csosborn/dt-nerdkit/pcb/NerdKit.brd

## EAGLE design pcb/NerdKit.brd (2015-12-04)

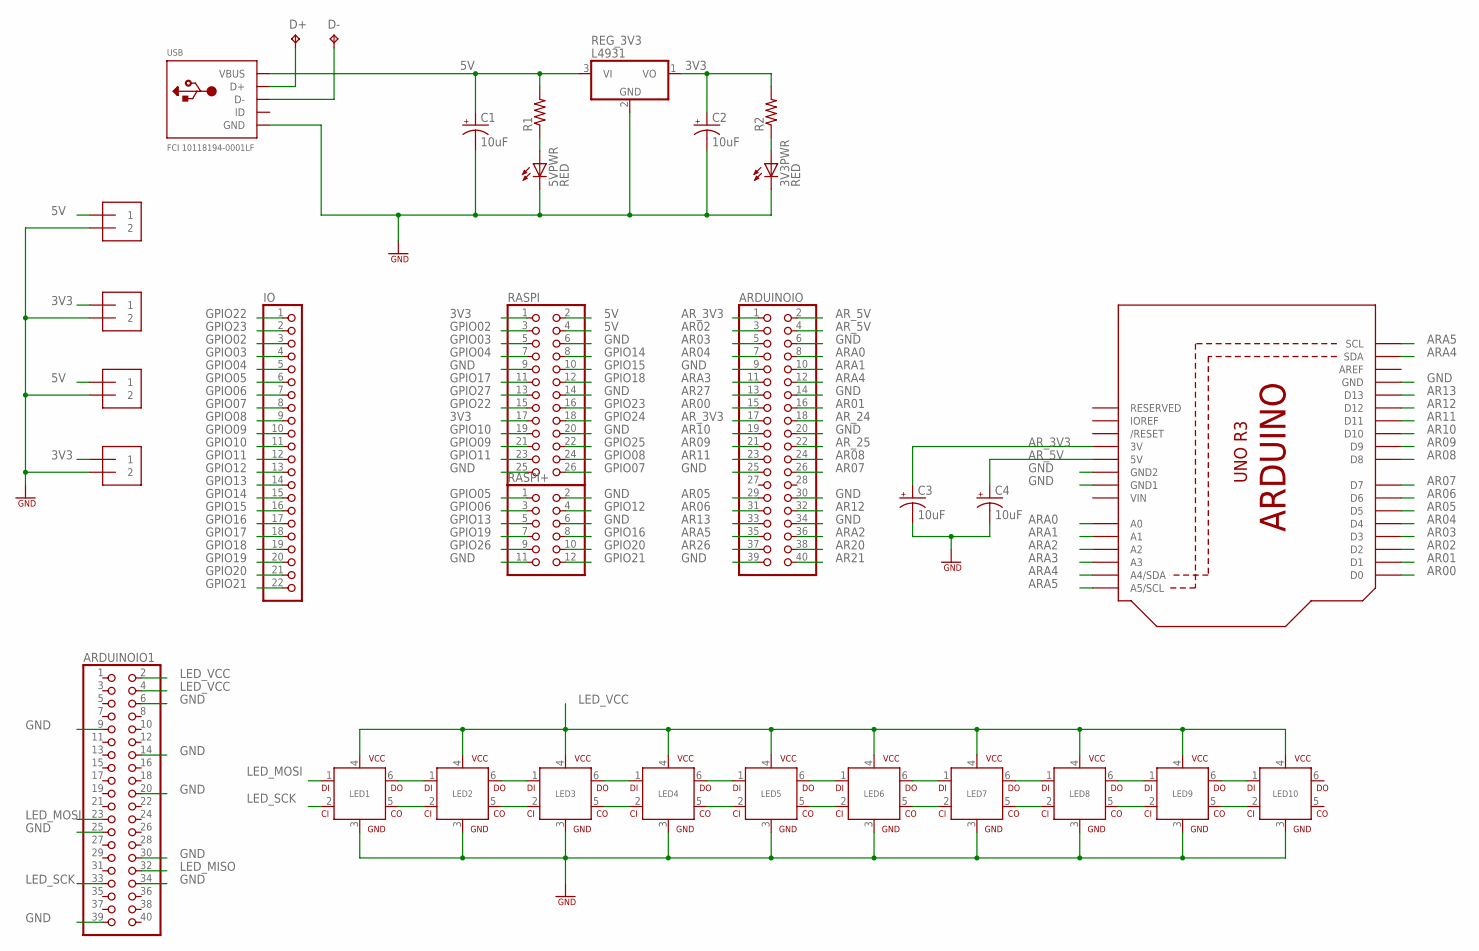
[picture p1: schematic NerdKit.sch]

Parts:
3V3PWR, 5VPWR: RED; LED3MM
ARDUINOIO, ARDUINOIO1: PINHD-2X20; 2X20
C1, C2, C3, C4: 10uF; E1,8-4
D+: TPPAD1-13; P1-13
D-: TPPAD1-13; P1-13
IO: PINHD-1X22; 1X22
LED1, LED2, LED3, LED4, LED5, LED6, LED7, LED8, LED9, LED10: RGBLED5050
PB1_TB_3V3, PB1_TB_5V, PB2_TB_3V3, PB2_TB_5V: 1X2-3.5MM
R1, R2: R-US_0207/7; 0207/7
RASPI: PINHD-2X13; 2X13
RASPI+: PINHD-2X6; 2X06
REG_3V3: L4931; TO92
U2: ARDUINOR3-PINSONLY; ARDUINOR3_PINSONLY
USB: FCI 10118194-0001LF; 4UCONN_20329

Connections:
3V3: C2.+, PB1_TB_3V3.1, PB2_TB_3V3.1, R2.2, RASPI.1, RASPI.17, REG_3V3.1 (VO)
5V: C1.+, PB1_TB_5V.1, PB2_TB_5V.1, R1.2, RASPI.2, RASPI.4, REG_3V3.3 (VI), USB.VBUS
AR00: ARDUINOIO.15, U2.D0
AR01: ARDUINOIO.16, U2.D1
AR02: ARDUINOIO.3, U2.D2
AR03: ARDUINOIO.5, U2.D3
AR04: ARDUINOIO.7, U2.D4
AR05: ARDUINOIO.29, U2.D5
AR06: ARDUINOIO.31, U2.D6
AR07: ARDUINOIO.26, U2.D7
AR08: ARDUINOIO.24, U2.D8
AR09: ARDUINOIO.21, U2.D9
AR10: ARDUINOIO.19, U2.D10
AR11: ARDUINOIO.23, U2.D11
AR12: ARDUINOIO.32, U2.D12
AR13: ARDUINOIO.33, U2.D13
AR20: ARDUINOIO.38
AR21: ARDUINOIO.40
AR26: ARDUINOIO.37
AR27: ARDUINOIO.13
ARA0: ARDUINOIO.8, U2.A0
ARA1: ARDUINOIO.10, U2.A1
ARA2: ARDUINOIO.36, U2.A2
ARA3: ARDUINOIO.11, U2.A3
ARA4: ARDUINOIO.12, U2.A4 (A4/SDA), U2.SDA
ARA5: ARDUINOIO.35, U2.A5 (A5/SCL), U2.SCL
AR_3V3: ARDUINOIO.1, ARDUINOIO.17, C3.+, U2.3V
AR_5V: ARDUINOIO.2, ARDUINOIO.4, C4.+, U2.5V
AR_24: ARDUINOIO.18
AR_25: ARDUINOIO.22
GND: 3V3PWR.K (C), 5VPWR.K (C), ARDUINOIO.6, ARDUINOIO.9, ARDUINOIO.14, ARDUINOIO.20, ARDUINOIO.25, ARDUINOIO.30, ARDUINOIO.34, ARDUINOIO.39, ARDUINOIO1.6, ARDUINOIO1.9, ARDUINOIO1.14, ARDUINOIO1.20, ARDUINOIO1.25, ARDUINOIO1.30, ARDUINOIO1.34, ARDUINOIO1.39, C1.-, C2.-, C3.-, C4.-, LED1.3 (GND), LED2.3 (GND), LED3.3 (GND), LED4.3 (GND), LED5.3 (GND), LED6.3 (GND), LED7.3 (GND), LED8.3 (GND), LED9.3 (GND), LED10.3 (GND), PB1_TB_3V3.2, PB1_TB_5V.2, PB2_TB_3V3.2, PB2_TB_5V.2, RASPI.6, RASPI.9, RASPI.14, RASPI.20, RASPI.25, RASPI+.2, RASPI+.6, RASPI+.11, REG_3V3.2 (GND), U2.GND, U2.GND1, U2.GND2, USB.BASE@1 (GND), USB.BASE@2 (GND), USB.GND, USB.SPRT@1 (GND), USB.SPRT@2 (GND), USB.SPRT@3 (GND), USB.SPRT@4 (GND)
GPIO02: IO.3, RASPI.3
GPIO03: IO.4, RASPI.5
GPIO04: IO.5, RASPI.7
GPIO05: IO.6, RASPI+.1
GPIO06: IO.7, RASPI+.3
GPIO07: IO.8, RASPI.26
GPIO08: IO.9, RASPI.24
GPIO09: IO.10, RASPI.21
GPIO10: IO.11, RASPI.19
GPIO11: IO.12, RASPI.23
GPIO12: IO.13, RASPI+.4
GPIO13: IO.14, RASPI+.5
GPIO14: IO.15, RASPI.8
GPIO15: IO.16, RASPI.10
GPIO16: IO.17, RASPI+.8
GPIO17: IO.18, RASPI.11
GPIO18: IO.19, RASPI.12
GPIO19: IO.20, RASPI+.7
GPIO20: IO.21, RASPI+.10
GPIO21: IO.22, RASPI+.12
GPIO22: IO.1, RASPI.15
GPIO23: IO.2, RASPI.16
GPIO24: RASPI.18
GPIO25: RASPI.22
GPIO26: RASPI+.9
GPIO27: RASPI.13
LED_MISO: ARDUINOIO1.32
LED_MOSI: ARDUINOIO1.23, LED1.1 (DI)
LED_SCK: ARDUINOIO1.33, LED1.2 (CI)
LED_VCC: ARDUINOIO1.2, ARDUINOIO1.4, LED1.4 (VCC), LED2.4 (VCC), LED3.4 (VCC), LED4.4 (VCC), LED5.4 (VCC), LED6.4 (VCC), LED7.4 (VCC), LED8.4 (VCC), LED9.4 (VCC), LED10.4 (VCC)
unnamed: 3V3PWR.A, R2.1
unnamed: D+.TP, USB.D+
unnamed: LED1.6 (DO), LED2.1 (DI)
unnamed: LED1.5 (CO), LED2.2 (CI)
unnamed: LED2.6 (DO), LED3.1 (DI)
unnamed: LED2.5 (CO), LED3.2 (CI)
unnamed: LED3.6 (DO), LED4.1 (DI)
unnamed: LED3.5 (CO), LED4.2 (CI)
unnamed: LED4.6 (DO), LED5.1 (DI)
unnamed: LED4.5 (CO), LED5.2 (CI)
unnamed: LED5.6 (DO), LED6.1 (DI)
unnamed: LED5.5 (CO), LED6.2 (CI)
unnamed: LED6.6 (DO), LED7.1 (DI)
unnamed: LED6.5 (CO), LED7.2 (CI)
unnamed: LED7.6 (DO), LED8.1 (DI)
unnamed: LED7.5 (CO), LED8.2 (CI)
unnamed: LED8.6 (DO), LED9.1 (DI)
unnamed: LED8.5 (CO), LED9.2 (CI)
unnamed: LED9.6 (DO), LED10.1 (DI)
unnamed: LED9.5 (CO), LED10.2 (CI)
unnamed: D-.TP, USB.D-
unnamed: 5VPWR.A, R1.1
VIN: U2.VIN

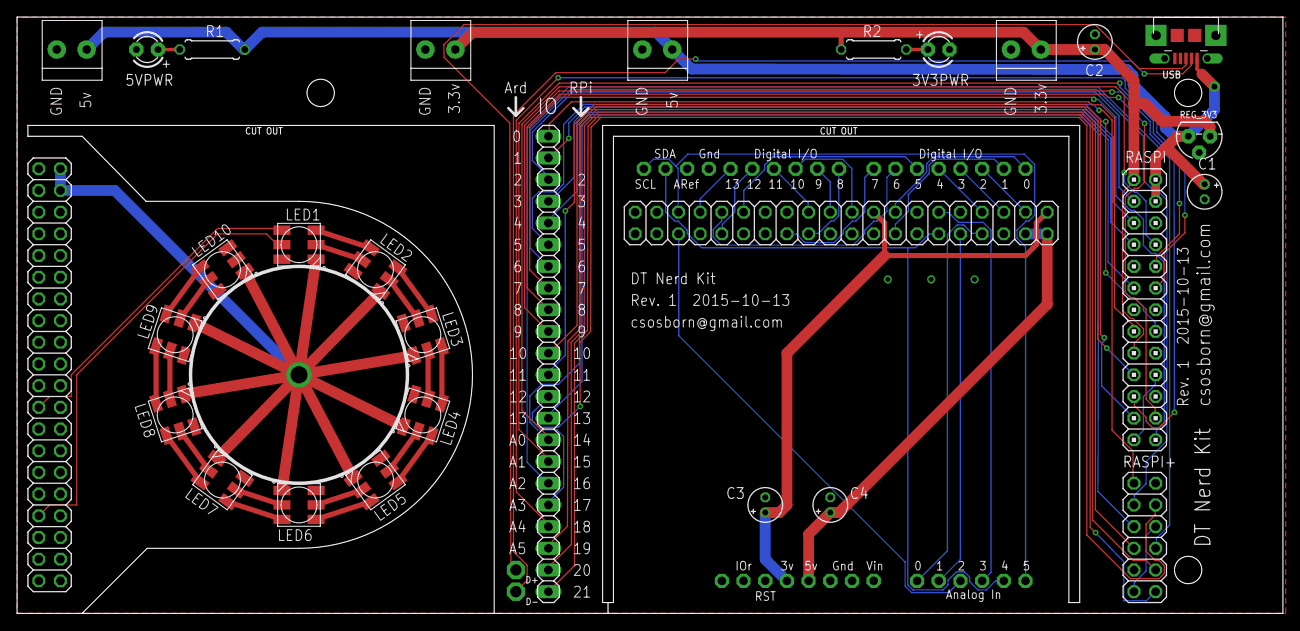
[picture p2: board NerdKit.brd from above]

Board: 2 copper layers, 148.3 x 69.8 mm, 32 parts (0 on the bottom side), 72 nets.
