csosborn/dt-nerdkit/(threads)

Thread 1 (2015-11-08):

Arduino shield daughter-card header is inverted

csosborn, 2015-11-08:
The daughter card should extend to the right when plugged into the header. Instead it must be rotated 180 degrees such that it extends to the right and overlaps the right breadboard.

csosborn, 2015-11-29:
Fixed by PR #6.

Closed 2015-11-29.

Thread 2 (2015-11-08):

Power terminal blocks slightly misaligned

csosborn, 2015-11-08:
The terminal blocks should align with the power buses on the solderless breadboards. They are slightly out of alignment.

Closed 2015-11-29.

Thread 3 (2015-11-08):

DC jack holes too large

csosborn, 2015-11-08:
The drill holes for the 2.1mm DC jack are too large for easy mounting/soldering.

csosborn, 2015-12-04:
Fixed by #11.

Closed 2015-12-04.

Thread 4 (2015-11-08):

Daughter cards aren't cut out properly

csosborn, 2015-11-08:
The boundary lines between the main board and the two daughter cards are just breaks in the copper pour, not actual milled cuts.

csosborn, 2015-11-29:
Fixed by #10.

Closed 2015-11-29.

Thread 5 (2015-11-08):

Linear regulator unsuitable for 5V supply

csosborn, 2015-11-08:
The linear regulator used to produce the 5V supply isn't a good fit for the intended uses of the overall kit. In particular it dissipates unreasonable amounts of power when the kit is driving a high-current device like a Rasberry Pi. A switched 5V supply would be preferable.

Closed 2015-12-04.

Thread 7 (2015-11-29):

LED6 on experimental board is missing its ground connection

csosborn, 2015-11-29:

Closed 2015-11-29.
