csosborn/dt-nerdkit/(commit log)

2015-11-05 Initial commit, including Rev 1 of the PCB.
    [NerdKit.brd, NerdKit.sch]
2015-11-29 Corrected the header orientation on the Arduino shield adapter card.
    [NerdKit.brd]
2015-11-29 Corrected the header orientation on the secondary LED card.
    [NerdKit.brd]
2015-11-29 Adjusted power terminal blocks and associated components 0.1" inboard.
    Fixes #2.
    [NerdKit.brd]
2015-11-29 Corrected schematic error on LED6 ground pin and adjusted copper pour.
    Fixes #7.
    [NerdKit.brd, NerdKit.sch]
2015-11-29 Added OSH Park compliant cutouts for daughter cards.
    See http://docs.oshpark.com/submitting-orders/cutouts-and-slots/.
    [NerdKit.brd, NerdKit.sch]
2015-12-04 Ditched the 2.1mm DC jack and regulator in favor of micro USB for power.
    This fixes #5.
    [NerdKit.brd, NerdKit.sch]
2015-12-04 Added mounting holes.
    Also brought the USB D+ and D- signals out to test points, just for fun.
    [NerdKit.brd, NerdKit.sch]
